open-neuroscience/Optogenetics-Chamber/bom.xlsx

item | detail | qty | unit cost (R$) | cost (BRL) | total cost | link
arduino mega headers | to stack shield on top of arduino | 1 | 55 | 55 | 829 | https://www.mercadolivre.com.br/shield-stacking-header-set-compatible-with-arduino-mega-2560/p/MLB2038789899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
arduino mega | take advantage of all digital outputs | 1 | 135 | 135 |  | https://www.mercadolivre.com.br/placa-compativel-arduino-mega-2560-ch340-atmega2560--cabo/up/MLBU759484633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
RGB LED | 5mm common cathode | 10 | 2 | 20 |  | https://www.mercadolivre.com.br/10-pecas-led-5mm-alto-brilho-rgb-catodo-comum/up/MLBU1437892895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
red led | 5 mm for indication | 10 | 2 | 20 |  | https://www.mercadolivre.com.br/kit-led-5mm-difuso-10-vermelho/p/MLB39027228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
220 ohm resistor | THT 1/4w kit 100 units | 1 | 25 | 25 |  | https://www.mercadolivre.com.br/kit-100un-resistor-220r-220-ohm-14w-5-carbono-cr25/up/MLBU3943781257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
flat cable | 26awg 5mt | 1 | 35 | 35 |  | https://www.mercadolivre.com.br/cabo-flat-cable-6-vias-26awg-colorido-lance-5mts/p/MLB2076010736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
mechanical switch | 2 positions | 20 | 1.5 | 30 |  | https://www.mercadolivre.com.br/20-pecas-micro-chave-interruptor-switch-pcb-2-posicao/up/MLBU596433095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
power supply | 12v 3a barrel connector | 1 | 19 | 19 |  | https://www.mercadolivre.com.br/fonte-alimentaco-12v-3a-pfita-led-cob-240l-cmera-bivolt/p/MLB2093977214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
PLA filament | 1kg | 1 | 130 | 130 |  | https://www.mercadolivre.com.br/filamento-pla-velvet-preto-1kg/p/MLB24741975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
idc board connector | THT | 10 | 5 | 50 |  | https://www.mercadolivre.com.br/10x--conector-barra-de-pinos-ds101310ssib1b-254mm-2x5/up/MLBU1749252615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
idc cable connector | Users will need and IDC crimper to make cables | 20 | 3 | 60
Custom printed circuit board | a shield for the mega board | 1 | 50 | 50 |  | jlcpcb.com
Custom printed circuit board | smaller pcb for holding LEDs | 10 | 20 | 200
