open-neuroscience/Optogenetics-Chamber/PCBs/LED_boards/production/bom.csv

Designator | Footprint | Quantity | Value | LCSC Part #
D1 | LED_D5.0mm-4_RGB_Wide_Pins | 1 | LED_RGBK
D2 | LED_D5.0mm_Clear | 1 | LED
J3 | IDC-Header_2x03_P2.54mm_Vertical | 1 | from_arduino
R1, R2, R3, R4 | R_Axial_DIN0309_L9.0mm_D3.2mm_P12.70mm_Horizontal | 4 | 220ohms
