open-neuroscience/Optogenetics-Chamber/CAD_designs/STLs/design_compatible_with_PCBs-mega_case_complete.3mf

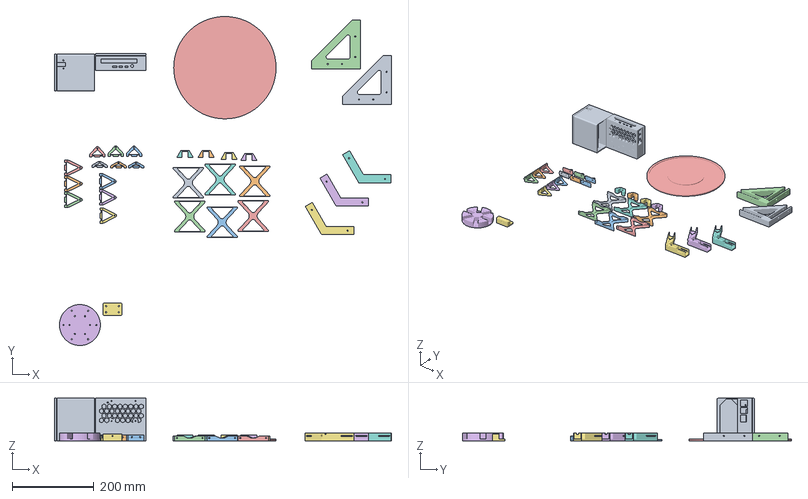
[picture p2: CAD file, 2026-08-19]
CAD_designs/STLs/design_compatible_with_PCBs-mega_case_complete.3mf
823.8 x 803.4 x 105.0 mm
all_enclosures.stl
vertical beam mount.stl x 4
screen bracket_17.stl x 3
makerbeam-join_90_deg.stl x 2
fly_base_250.stl
central_join.stl
camera_mount.stl
Frame X-brace 75x75mm.STL x 6
screen bracket_8.stl x 3
makerbeam-join.stl x 3
screen bracket_34.stl x 3
screen bracket_32.stl x 3
