open-neuroscience/Optogenetics-Chamber/CAD_designs/STLs/design_compatible_with_PCBs-complete_lid.3mf

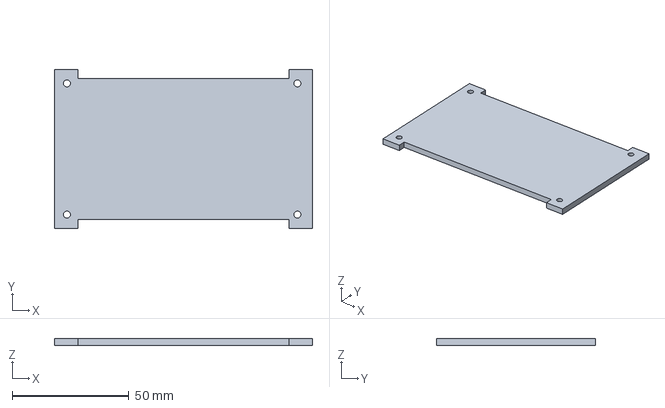
[picture p3: CAD file, 2026-07-24]
CAD_designs/STLs/design_compatible_with_PCBs-complete_lid.3mf
110.5 x 68.0 x 3.00 mm
