open-neuroscience/Optogenetics-Chamber/CAD_designs/design_compatible_with_PCBs.FCStd

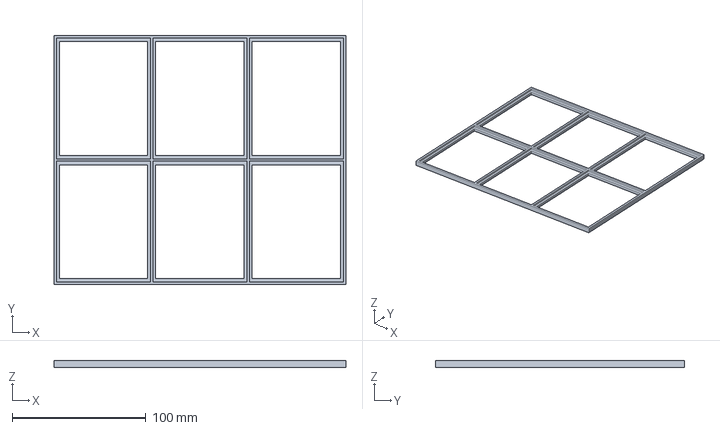
[picture p4: CAD file, 2026-08-24]
CAD_designs/design_compatible_with_PCBs.FCStd
218.2 x 186.2 x 5.00 mm
