open-neuroscience/Optogenetics-Chamber/CAD_designs/STLs/original_paper/Three Drawer Opto Box.stl

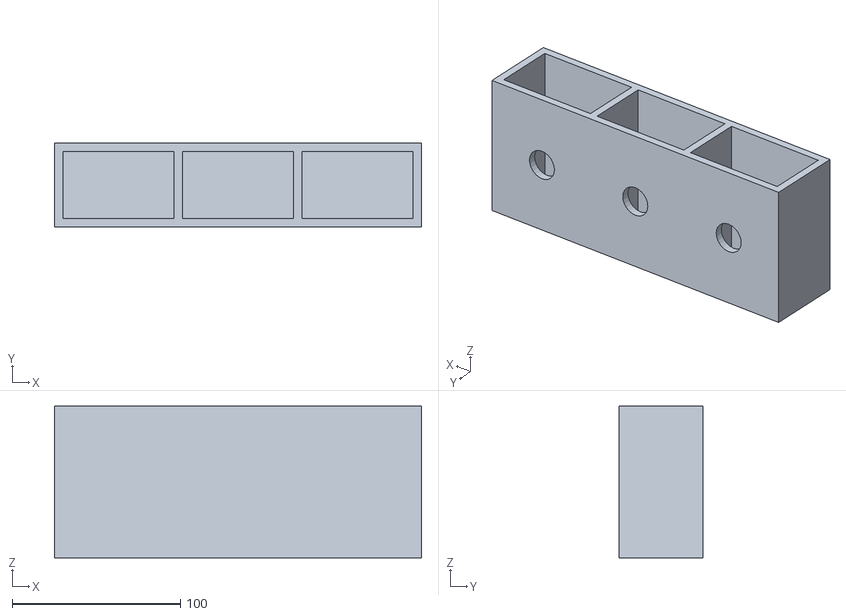
[picture p5: CAD file, 2026-07-24]
CAD_designs/STLs/original_paper/Three Drawer Opto Box.stl
218.0 x 50.0 x 90.0
