open-neuroscience/Optogenetics-Chamber/CAD_designs/paper_CAD_reimplementation_in_FreeCad.FCStd

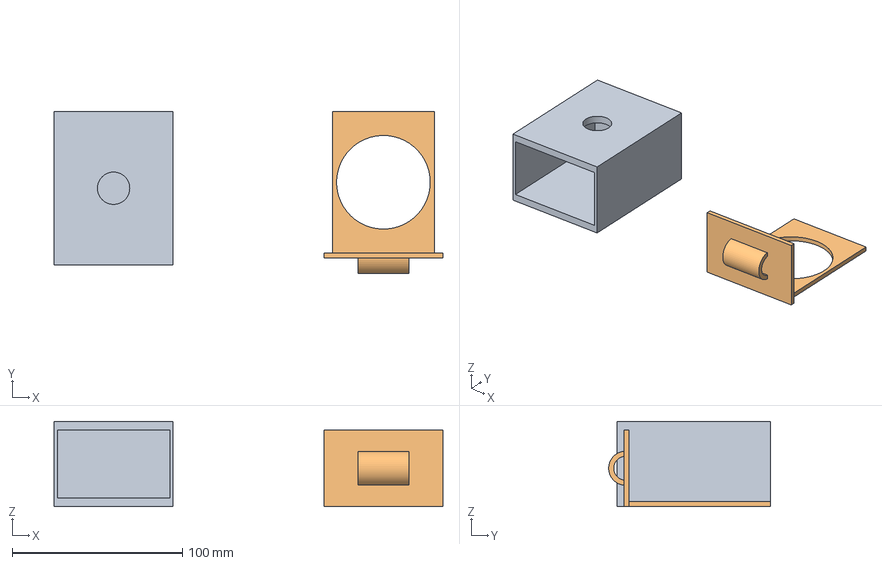
[picture p6: CAD file, 2026-07-24]
CAD_designs/paper_CAD_reimplementation_in_FreeCad.FCStd
228.5 x 95.0 x 50.0 mm
drawer_outer_part
drawer_w_handle
