open-neuroscience/Optogenetics-Chamber/CAD_designs/STLs/original_paper/Drawers for 3 opto box number 2.stl

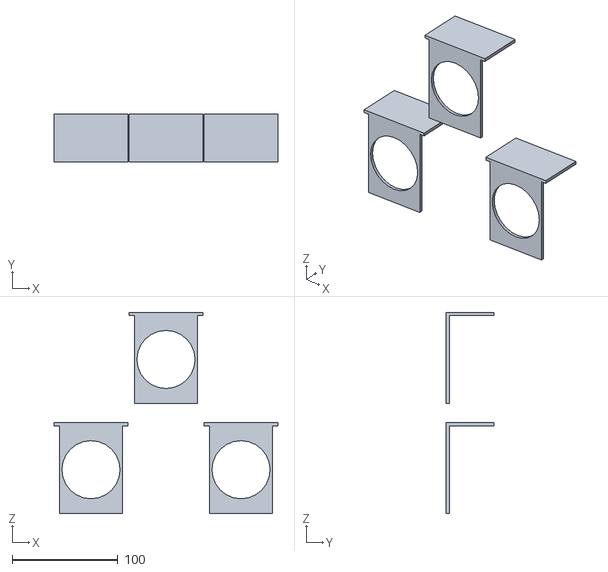
[picture p7: CAD file, 2026-07-24]
CAD_designs/STLs/original_paper/Drawers for 3 opto box number 2.stl
212.0 x 45.0 x 190.3
