open-neuroscience/Optogenetics-Chamber/CAD_designs/STLs/design_compatible_with_PCBs-drawer_w_handle.3mf

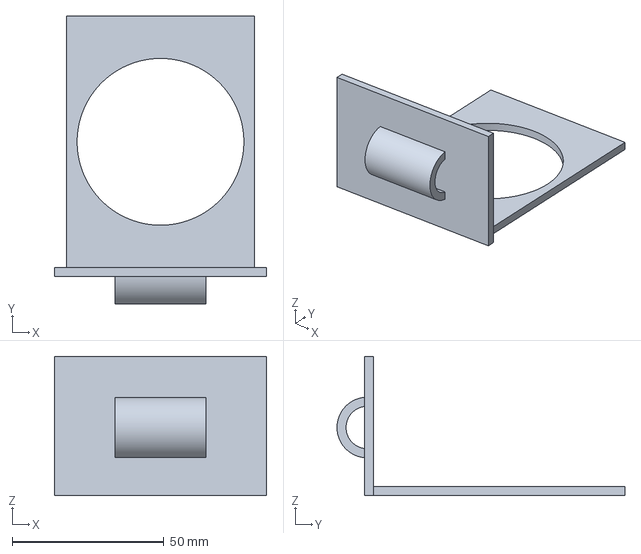
[picture p8: CAD file, 2026-07-26]
CAD_designs/STLs/design_compatible_with_PCBs-drawer_w_handle.3mf
70.0 x 95.0 x 46.0 mm
