open-neuroscience/Optogenetics-Chamber/CAD_designs/STLs/original_paper/Three Drawer Handles.stl

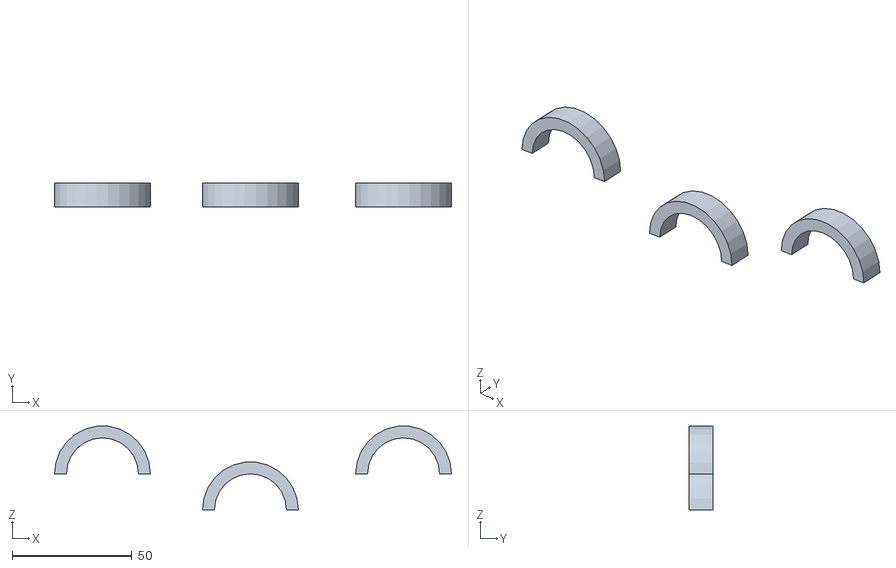
[picture p9: CAD file, 2026-07-24]
CAD_designs/STLs/original_paper/Three Drawer Handles.stl
165.6 x 10.00 x 34.9
