open-neuroscience/Optogenetics-Chamber/CAD_designs/STLs/design_compatible_with_PCBs-lid_with_writing.3mf

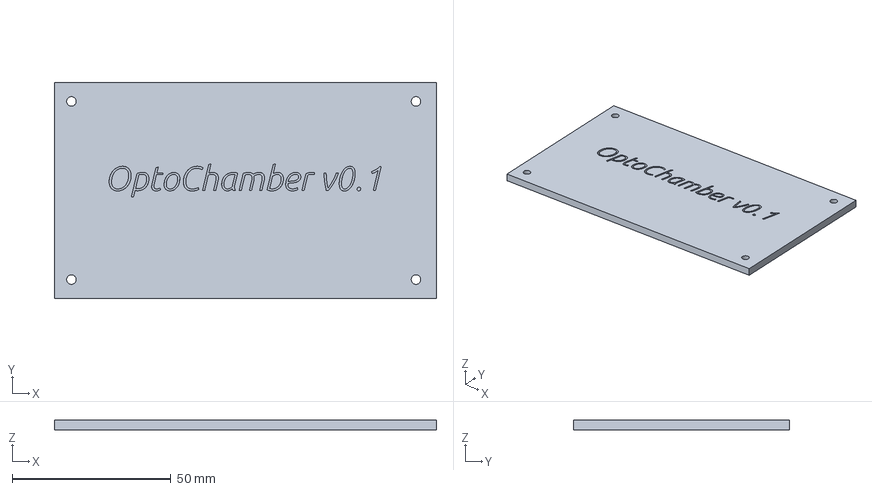
[picture p10: CAD file, 2026-07-26]
CAD_designs/STLs/design_compatible_with_PCBs-lid_with_writing.3mf
120.5 x 68.0 x 3.00 mm
