open-neuroscience/Optogenetics-Chamber/CAD_designs/STLs/design_compatible_with_PCBs-drawer_case.3mf

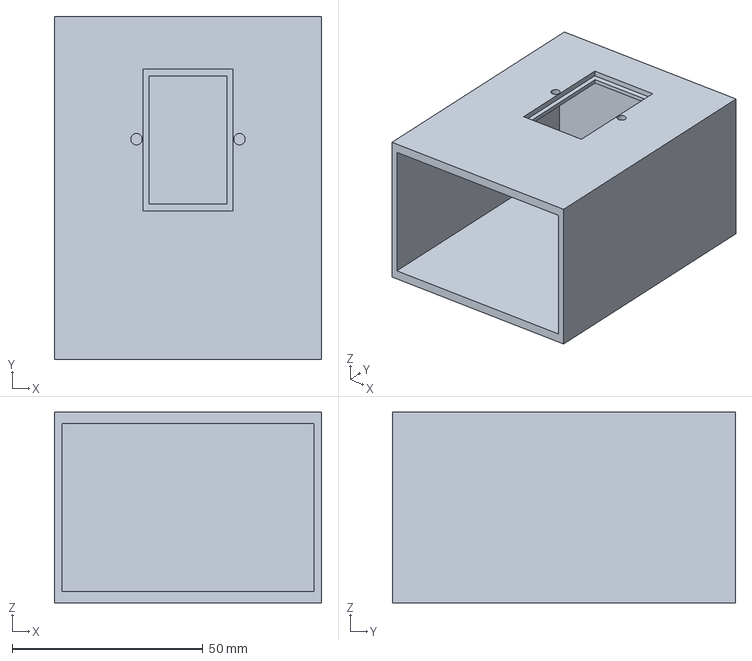
[picture p11: CAD file, 2026-07-26]
CAD_designs/STLs/design_compatible_with_PCBs-drawer_case.3mf
70.0 x 90.0 x 50.0 mm
