open-neuroscience/Optogenetics-Chamber/CAD_designs/STLs/design_compatible_with_PCBs-mega_case_wtih_screw_holes.3mf

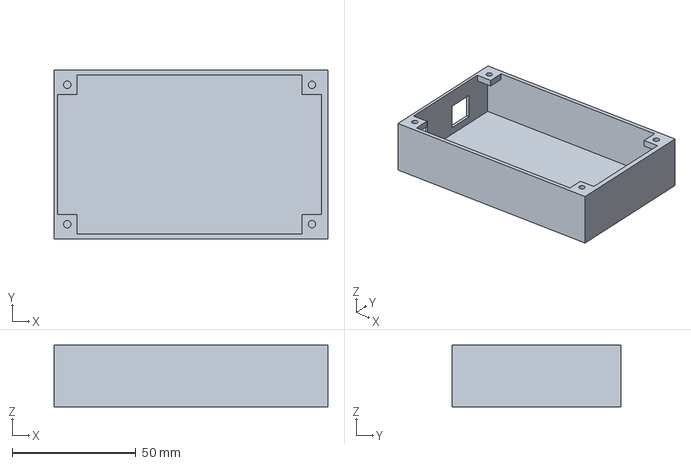
[picture p12: CAD file, 2026-07-24]
CAD_designs/STLs/design_compatible_with_PCBs-mega_case_wtih_screw_holes.3mf
110.5 x 68.0 x 25.0 mm
