open-neuroscience/Optogenetics-Chamber/(list of files, cad)

Other CAD files:
CAD_designs/STLs/design_compatible_with_PCBs-array_holder.stl
