open-neuroscience/Optogenetics-Chamber/PCBs/main/main.kicad_pcb

## KiCad design PCBs/main/main.kicad_pcb (2026-07-24)

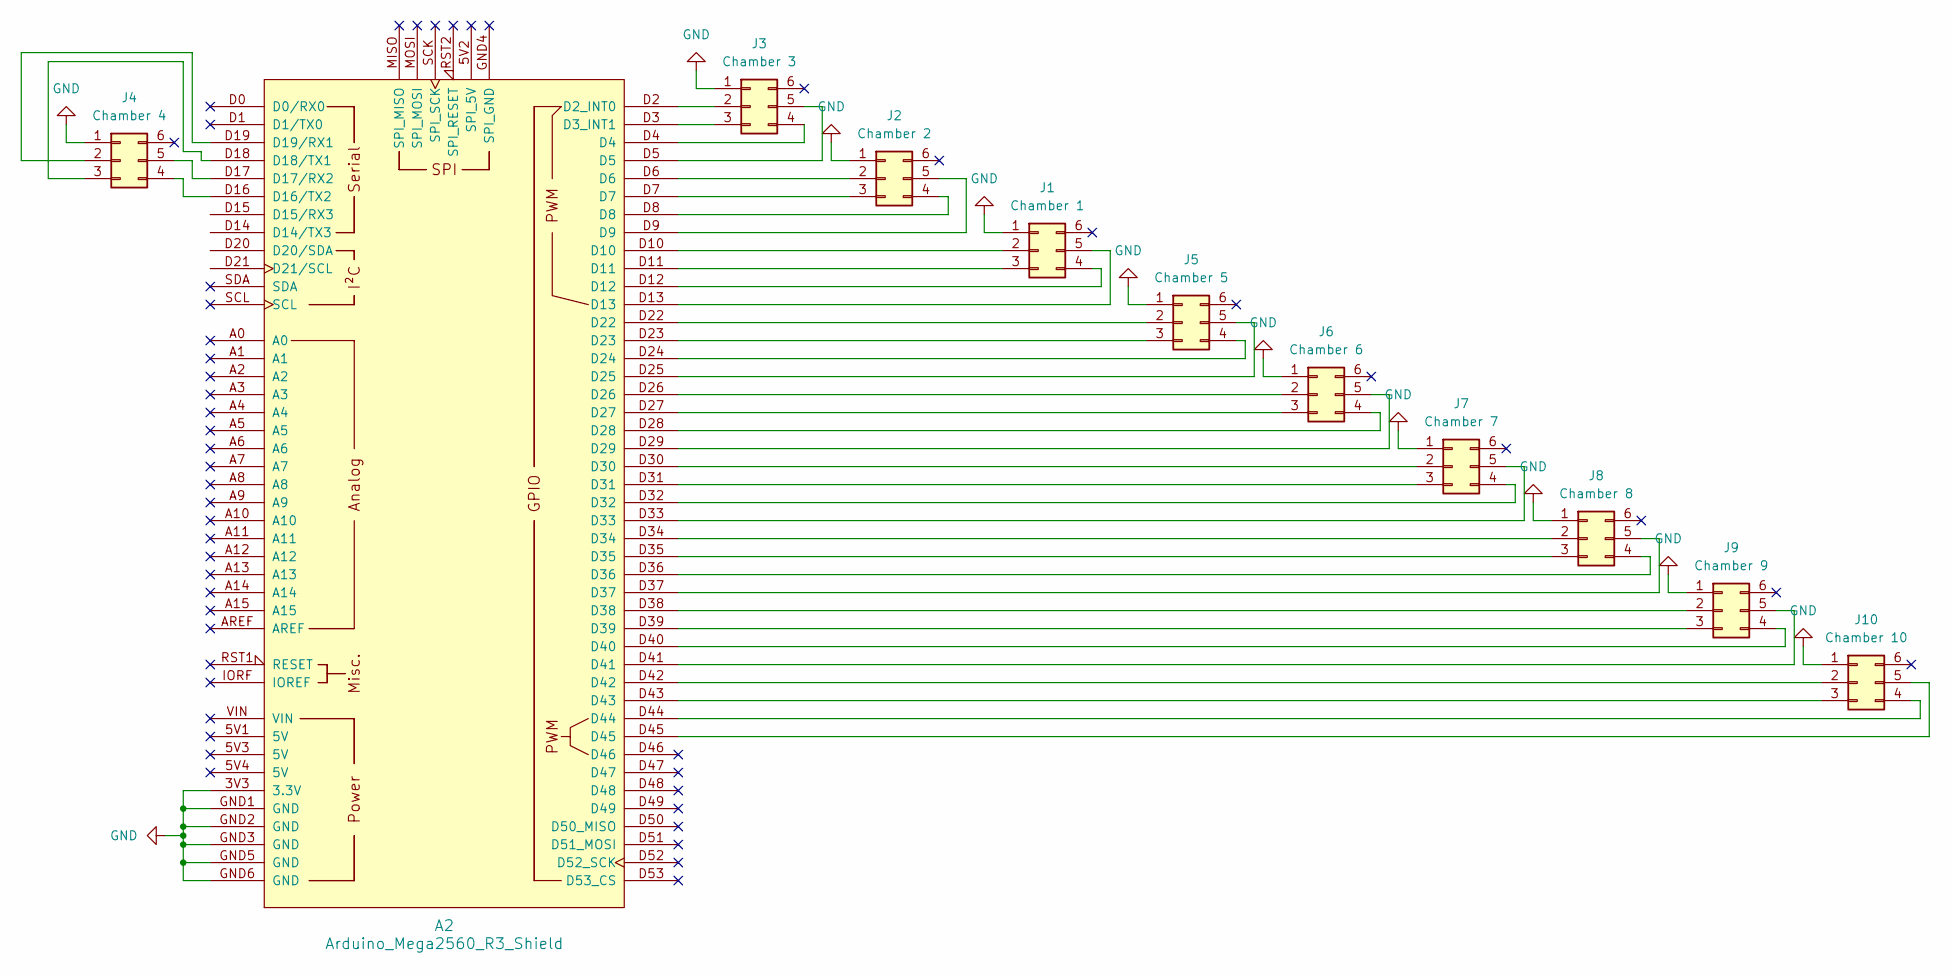
[picture p13: schematic main.kicad_sch]

Parts:
A2: Arduino_Mega2560_R3_Shield
J1: Chamber 1; IDC-Header_2x03_P2.54mm_Vertical
J2: Chamber 2; IDC-Header_2x03_P2.54mm_Vertical
J3: Chamber 3; IDC-Header_2x03_P2.54mm_Vertical
J4: Chamber 4; IDC-Header_2x03_P2.54mm_Vertical
J5: Chamber 5; IDC-Header_2x03_P2.54mm_Vertical
J6: Chamber 6; IDC-Header_2x03_P2.54mm_Vertical
J7: Chamber 7; IDC-Header_2x03_P2.54mm_Vertical
J8: Chamber 8; IDC-Header_2x03_P2.54mm_Vertical
J9: Chamber 9; IDC-Header_2x03_P2.54mm_Vertical
J10: Chamber 10; IDC-Header_2x03_P2.54mm_Vertical

Connections:
GND: A2.3V3 (3.3V), A2.GND1 (GND), A2.GND2 (GND), A2.GND3 (GND), A2.GND5 (GND), A2.GND6 (GND), J1.1, J2.1, J3.1, J4.1, J5.1, J6.1, J7.1, J8.1, J9.1, J10.1
unnamed: A2.D2 (D2_INT0), J3.2
unnamed: A2.D3 (D3_INT1), J3.3
unnamed: A2.D16 (D16/TX2), J4.4
unnamed: A2.D17 (D17/RX2), J4.5
unnamed: A2.D18 (D18/TX1), J4.3
unnamed: A2.D19 (D19/RX1), J4.2
unnamed: A2.D10, J1.2
unnamed: A2.D11, J1.3
unnamed: A2.D12, J1.4
unnamed: A2.D13, J1.5
unnamed: A2.D6, J2.2
unnamed: A2.D7, J2.3
unnamed: A2.D8, J2.4
unnamed: A2.D9, J2.5
unnamed: A2.D4, J3.4
unnamed: A2.D5, J3.5
unnamed: A2.D22, J5.2
unnamed: A2.D23, J5.3
unnamed: A2.D24, J5.4
unnamed: A2.D25, J5.5
unnamed: A2.D26, J6.2
unnamed: A2.D27, J6.3
unnamed: A2.D28, J6.4
unnamed: A2.D29, J6.5
unnamed: A2.D30, J7.2
unnamed: A2.D31, J7.3
unnamed: A2.D32, J7.4
unnamed: A2.D33, J7.5
unnamed: A2.D34, J8.2
unnamed: A2.D35, J8.3
unnamed: A2.D36, J8.4
unnamed: A2.D37, J8.5
unnamed: A2.D38, J9.2
unnamed: A2.D39, J9.3
unnamed: A2.D40, J9.4
unnamed: A2.D41, J9.5
unnamed: A2.D42, J10.2
unnamed: A2.D43, J10.3
unnamed: A2.D44, J10.4
unnamed: A2.D45, J10.5

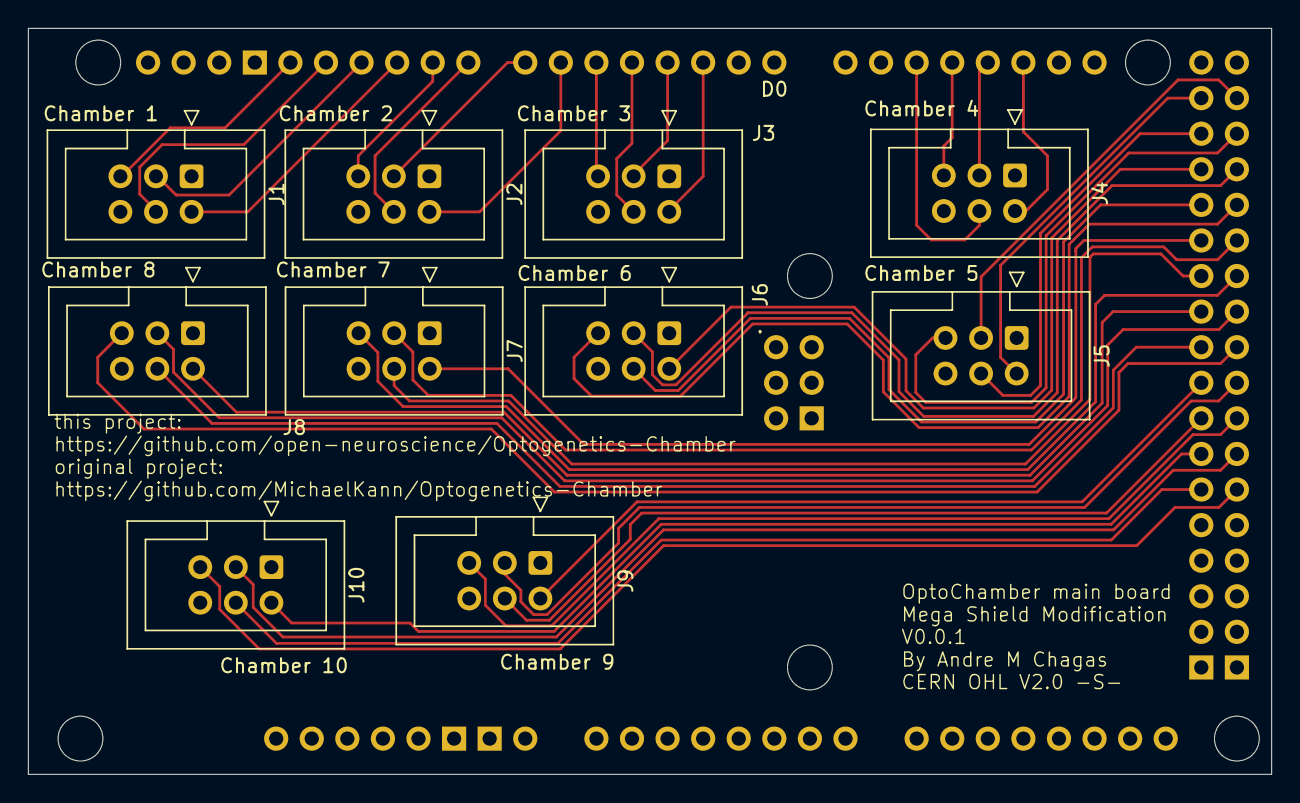
[picture p14: board main.kicad_pcb from above]

Board: 2 copper layers, 88.8 x 53.2 mm, 11 parts (0 on the bottom side), 41 nets.
