open-neuroscience/Optogenetics-Chamber/PCBs/LED_boards/led_boards.kicad_pcb

## KiCad design PCBs/LED_boards/led_boards.kicad_pcb (2026-07-24)

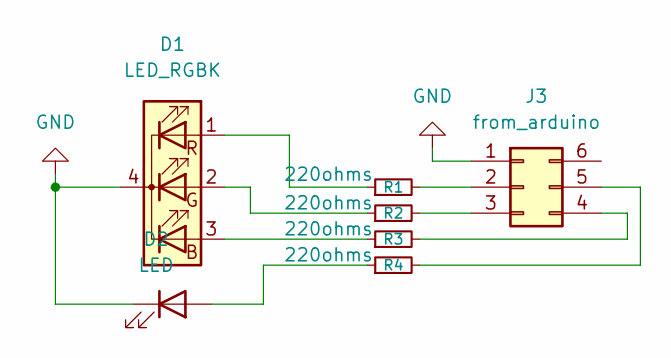
[picture p15: schematic led_boards.kicad_sch]

Parts:
D1: LED_RGBK; LED_D5.0mm-4_RGB_Wide_Pins
D2: LED; LED_D5.0mm_Clear
J3: from_arduino; IDC-Header_2x03_P2.54mm_Vertical
R1, R2, R3, R4: 220ohms; R_Axial_DIN0309_L9.0mm_D3.2mm_P12.70mm_Horizontal

Connections:
GND: D1.4 (K), D2.1 (K), J3.1
unnamed: D1.3 (BA), R3.1
unnamed: D1.2 (GA), R2.1
unnamed: D1.1 (RA), R1.1
unnamed: D2.2 (A), R4.1
unnamed: J3.2, R1.2
unnamed: J3.3, R2.2
unnamed: J3.4, R3.2
unnamed: J3.5, R4.2

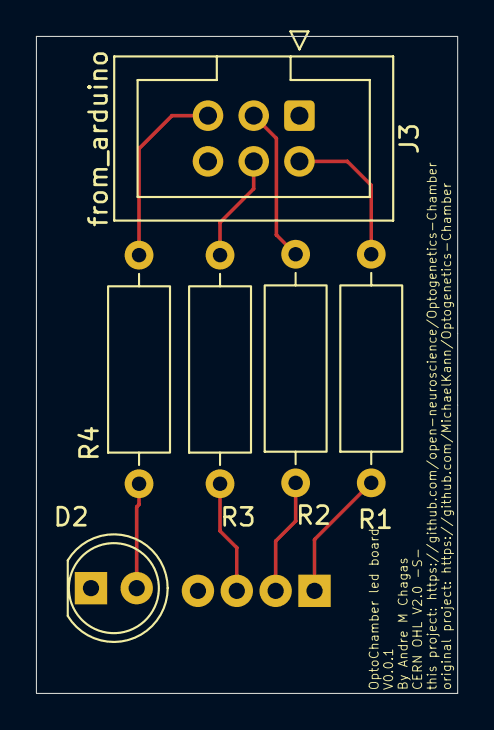
[picture p16: board led_boards.kicad_pcb from above]

Board: 2 copper layers, 23.4 x 36.5 mm, 7 parts (1 on the bottom side), 9 nets.
