open-neuroscience/Optogenetics-Chamber/(commit log)

2026-06-22 start creating arduino mega shield and bill of materials
    [bom.xlsx, main.kicad_pcb, main.kicad_sch]
2026-06-22 update bill of materials
    [bom.xlsx]
2026-06-24 add cost for the mega board PCB shield
    [bom.xlsx]
2026-06-24 work on first prototype for the boards
    [led_boards.kicad_pcb, led_boards.kicad_sch, main.kicad_pcb, main.kicad_sch]
2026-06-25 create parts for 3D printing
    [freecad_implementation.FCStd, led_boards.kicad_sch]
2026-06-26 update bom and finish first version of PCBs
    [bom.csv, bom.xlsx, designators.csv, led_boards.kicad_pcb, led_boards.kicad_sch, main.kicad_pcb, main.kicad_sch, positions.csv]
2026-06-26 last save after production board was made
    [main.kicad_pcb]
2026-07-24 create PCBs for easier replication of the system. It has been altered to use an arduino Mega, instead of an arduino Uno.
    [bom.csv, designators.csv, led_boards.kicad_pcb, led_boards.kicad_sch, main.kicad_pcb, main.kicad_sch, positions.csv]
2026-07-24 create freecad implementations of the Autocad designs and create a casing for the arduino mega
    [Drawers for 3 opto box number 2.stl, Three Drawer Handles.stl, Three Drawer Opto Box.stl, design_compatible_with_PCBs-complete_lid.3mf, design_compatible_with_PCBs-drawer_case.3mf, design_compatible_with_PCBs-drawer_w_handle.3mf, design_compatible_with_PCBs-mega_case_complete.3mf, design_compatible_with_PCBs-mega_case_wtih_screw_holes.3mf]
2026-07-26 update tested CAD designs
    [design_compatible_with_PCBs-drawer_case.3mf, design_compatible_with_PCBs-drawer_w_handle.3mf, design_compatible_with_PCBs-lid_with_writing.3mf, design_compatible_with_PCBs-mega_case_complete.3mf, design_compatible_with_PCBs.FCStd]
2026-08-19 finish design case
    [design_compatible_with_PCBs-mega_case_complete.3mf, design_compatible_with_PCBs.FCStd]
2026-08-19 polish main pcb
    [main.kicad_sch]
2026-08-24 create a holder for all drawers
    [design_compatible_with_PCBs-array_holder.stl, design_compatible_with_PCBs.FCStd]
