open-neuroscience/Optogenetics-Chamber/(notices)

Notices in the files:
PCBs/LED_boards/led_boards.kicad_pcb:
CERN OHL V2.0 -S-
